kpayinda/PIM/(commit log)

2026-06-17 Initial commit of local KiCad project copy
    [PIM_V01.kicad_sch, POWER.kicad_sch]
2026-07-30 a month of progress, schematic is nearly done (just needs to be checked), and layout is getting close'
    [CAN.kicad_sch, HK_POWER.kicad_sch, PAYLOAD_POWER.kicad_sch, PIM_V01.kicad_pcb, PIM_V01.kicad_sch, SMPS1.kicad_sch, untitled.kicad_sch]
2026-07-30 fixed schematic file names
    [HK_POWER.kicad_sch, PIM_V01.kicad_sch, POWER.kicad_sch, untitled.kicad_sch]
2026-07-30 updated schematic to include FRAM. Ben to review soon'
    [CAN.kicad_sch, PIM_V01.kicad_pcb, PIM_V01.kicad_sch, POWER.kicad_sch]
2026-08-04 minor updates to sch, bigger updates to pcb, after this push i am moving to double sided pcb for space optimisation
    [CAN.kicad_sch, PIM_V01.kicad_pcb, PIM_V01.kicad_sch, POWER.kicad_sch]
2026-08-06 ben to review, added mounting holes and finished the rest of the layout; also labelled more of the pinouts and added leds and tps
    [CAN.kicad_sch, PIM_V01.kicad_sch]
